ivan-jankovic/env-monitor/hardware/env-monitor.kicad_sch

## KiCad design hardware/env-monitor.kicad_sch (2026-10-29)

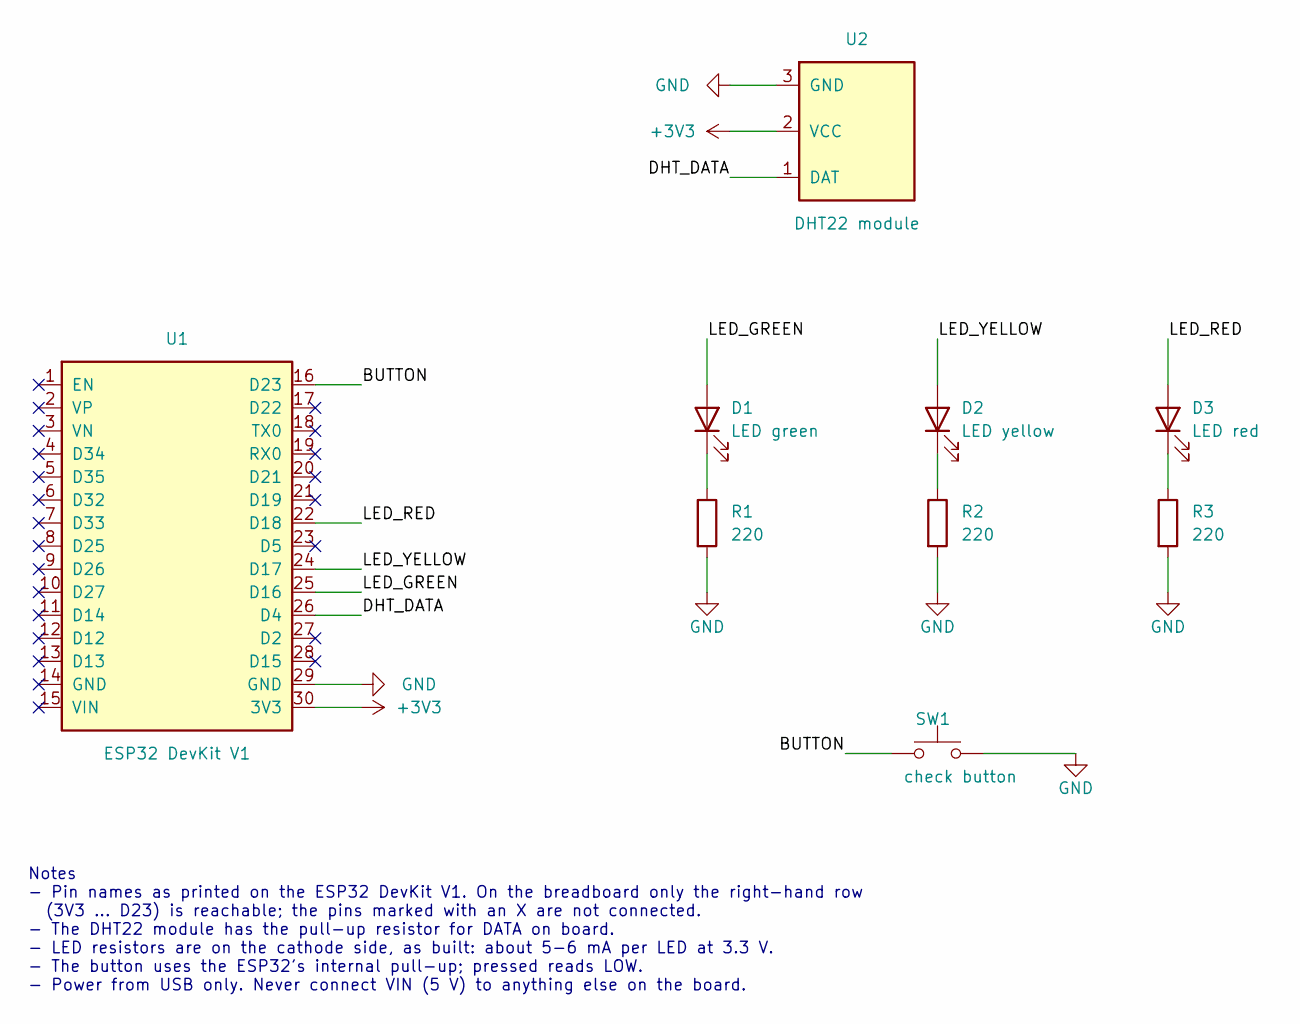
[picture p3: schematic env-monitor.kicad_sch]

Parts:
D1: LED green
D2: LED yellow
D3: LED red
R1, R2, R3: 220
SW1: check button
U1: ESP32 DevKit V1
U2: DHT22 module

Connections:
+3V3: U1.30 (3V3), U2.2 (VCC)
BUTTON: SW1.1, U1.16 (D23)
DHT_DATA: U1.26 (D4), U2.1 (DAT)
GND: R1.2, R2.2, R3.2, SW1.2, U1.29 (GND), U2.3 (GND)
LED_GREEN: D1.2 (A), U1.25 (D16)
LED_RED: D3.2 (A), U1.22 (D18)
LED_YELLOW: D2.2 (A), U1.24 (D17)
unnamed: D1.1 (K), R1.1
unnamed: D2.1 (K), R2.1
unnamed: D3.1 (K), R3.1

Notes on the sheet:
Notes - Pin names as printed on the ESP32 DevKit V1. On the breadboard only the right-hand row (3V3 ... D23) is reachable; the pins marked with an X are not connected. - The DHT22 module has the pull-up resistor for DATA on board. - LED resistors are on the cathode side, as built: about 5-6 mA per 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
