ivan-jankovic/env-monitor/firmware/include/uplink.h

// Gets readings to the server reliably: every sample goes into a RAM buffer,
// which is drained oldest first. Failed sends are retried with exponential
// backoff; the server ignores duplicates, so resending is safe.
#pragma once

#include <stddef.h>
#include <time.h>

namespace uplink {

void add(time_t ts, double temperature, double humidity);
void loop();  // call on every loop() iteration
size_t pending();

// Delivering normally: WiFi up, the last send succeeded and no retry is
// pending. False from boot until the first successful send.
bool healthy();

}  // namespace uplink
