ivan-jankovic/env-monitor/(commit log)

2026-10-29 Read the DHT22 through a sensor class and post readings to the API
2026-10-29 Fetch alarm limits and evaluate alarms on the device
2026-10-29 Drive status LEDs and add an on-demand check button
2026-10-29 Add README with setup, wiring and known limitations
2026-10-29 Clarify wiring and port comments
2026-10-29 Add a photo of the breadboard wiring to the README
2026-10-29 Ignore KiCad's per-user and temporary files
2026-10-29 Add KiCad schematic of the breadboard wiring
2026-10-29 Move the schematic notes below the ESP32
2026-10-29 Pin the ESP32 platform version
2026-10-29 Pin setup-uv to an exact release
